EventAccess/NFCScanner/README.md

# NFCScanner
Maskinvare &amp; Firmware for in/ut-scanning

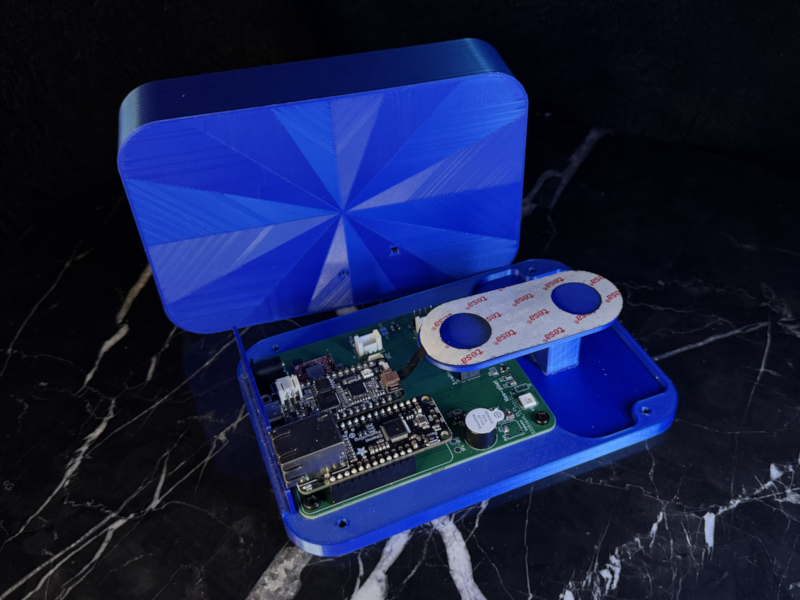
[picture p1: doc/img/prototype_0.0.4+case_800.png]
Picture of first prototype, fully assembled but with top cover off
