EventAccess/NFCScanner/hardware/Case/Cost calculations.md

backplate: 0.96m / 2.32cm³ / 2.87g
top: 26.77m / 64.39cm³ / (calculated 79.835700886g)
bottom: 19.19m / 46151.52mm³ / 57.23g
antenna shelf: 2.21m / 5325.38mm³ / 6.6g

ca. cost for 1x case: 112kr (prusament single spool 1kg, shipped - litt over halve prisen er porto)
this does not account for the back-plate, for example, needing multiple iterations.

Based on a single spool of filament at 30€, and todays currency conversion (XE), and also including the 34.5€ for cheapest shipping (direct from Prusa).
