EventAccess/NFCScanner/hardware/Case/Case.FCStd

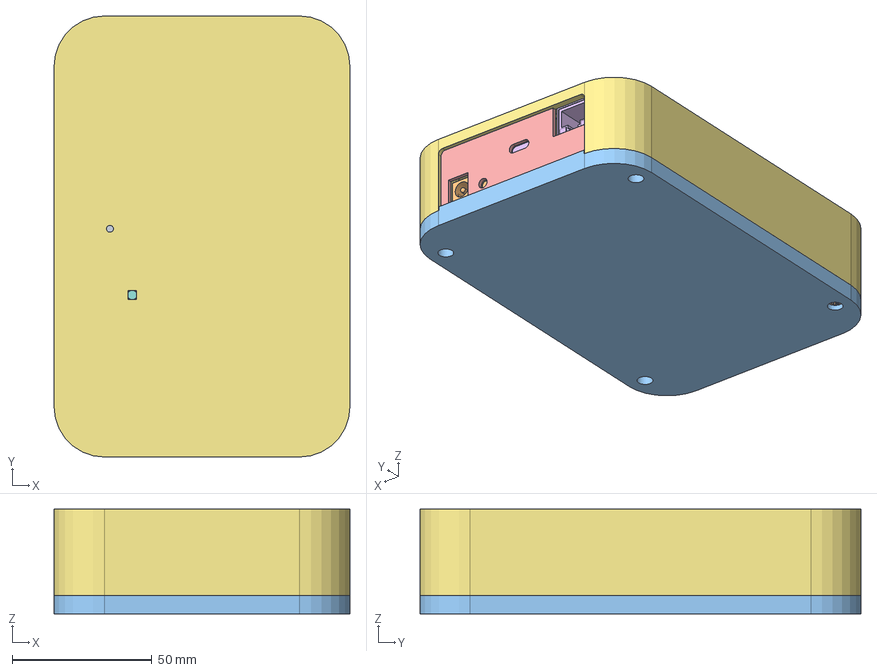
[picture p2: CAD file, 2025-02-13]
hardware/Case/Case.FCStd
106.0 x 158.0 x 37.5 mm
PinHeader_1x03_P254mm_Vertical
CUI_DEVICES_TS11-674-105-BK-260-RA-D
Grove Connector (standing)
SOT_23_5
Grove Connector (standing)001
PinHeader_1x04_P254mm_Vertical
SparkFun_Buck_Regulator_AP63357DV-7_BabyBuck5V_boardonly 1
SOT_323_SC_70
AT-1224-TWT-5V-2-R
BarrelJack_Horizontal
PinHeader_1x04_P254mm_Vertical001
SOT_323_SC_071
BM04B-SRSS-TBT
Adafruit Ethernet FeatherWing v2
PinSocket_1x16_P2.54mm_Vertical
PinSocket_1x12_P2.54mm_Vertical
PinHeader_1x16_P254mm_Vertical
PinHeader_1x12_P254mm_Vertical
PinSocket_1x16_P2.54mm_Vertical002
PinSocket_1x12_P2.54mm_Vertical002
PinHeader_1x16_P254mm_Vertical001
PinHeader_1x12_P254mm_Vertical001
PinSocket_1x03_P2.54mm_Vertical
LED_WS2812B_PLCC4_50x50mm_P32mm
NfcCarrierBoard_PCB
AntennaBody
BottomBody
M3x4-Insert x 3
BackPanelBody
USBPortBody
TopBody
AntennaShelfBody
M3x4-Insert004
M3x6-Screw004
