EventAccess/NFCScanner/hardware/NfcCarrierBoard/NfcCarrierBoard.kicad_pcb

## KiCad design hardware/NfcCarrierBoard/NfcCarrierBoard.kicad_pcb (2025-02-13)

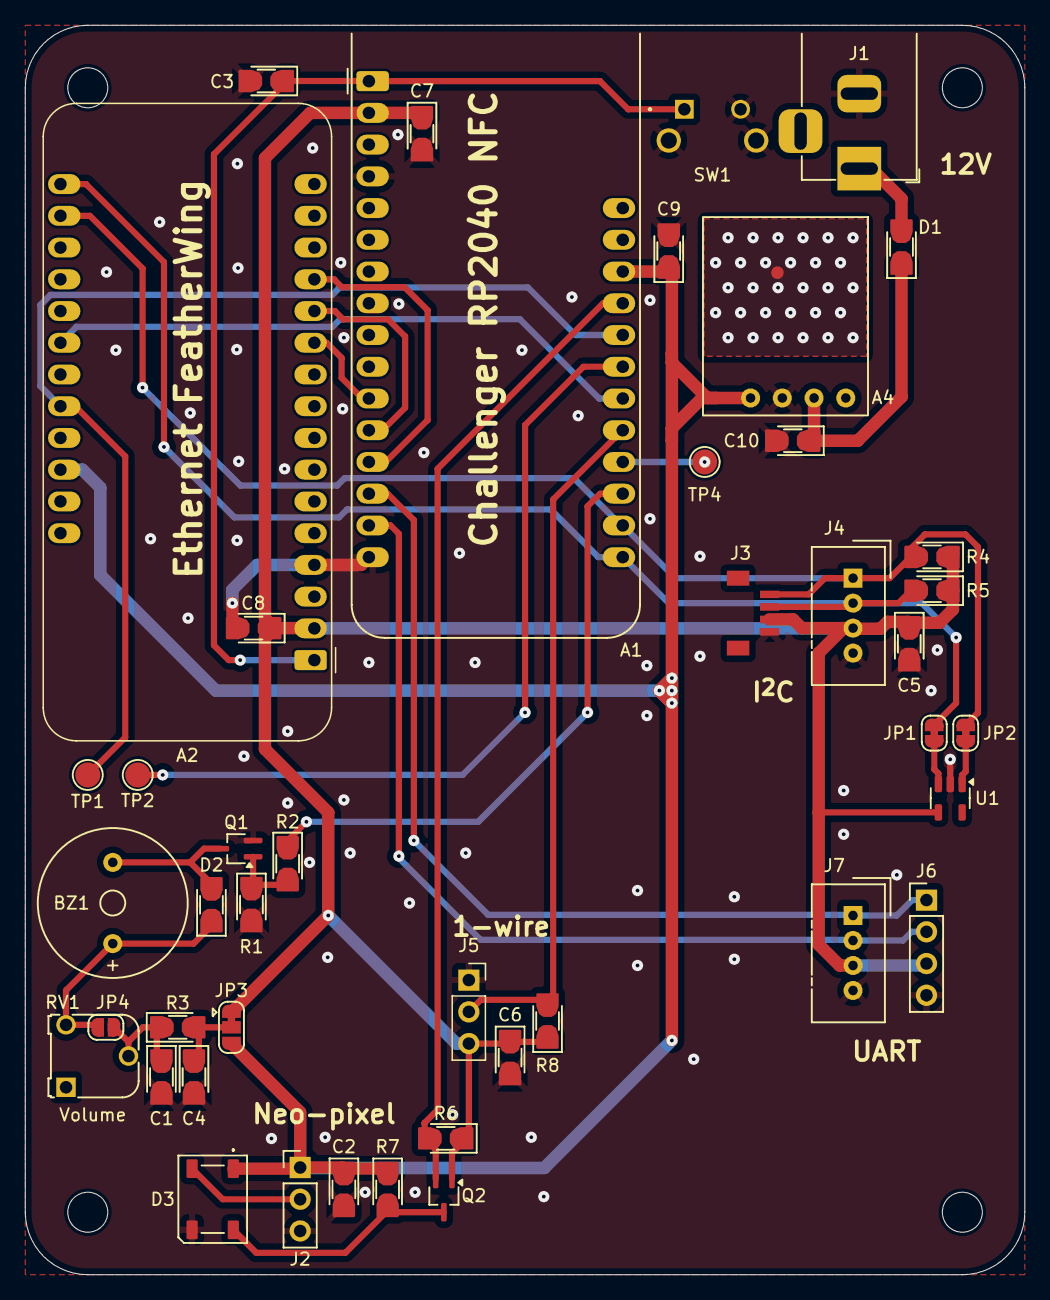
[picture p3: board NfcCarrierBoard.kicad_pcb from above]

Board: 2 copper layers, 80.0 x 100.0 mm, 50 parts (1 on the bottom side), 29 nets.

Parts:
A1: iLabs Challenger RP2040 NFC; Adafruit_Feather
A2: Ethernet FeatherWing; Adafruit_Feather
A4: 5V 3A Buck Reg; SparkFun BabyBuck Regulator 5V
BZ1: Buzzer; Buzzer_PUIaudio_AT-1224-TWT_D12_H9_6.5mm
C1: 10µF; SMD_HANDSOLDER_UNIVERSAL_0603_0805_1206
C2, C3, C4, C5, C6, C7, C8, C9, C10: 0.1µF; SMD_HANDSOLDER_UNIVERSAL_0603_0805_1206
D1, D2: SL54A; SMD_HANDSOLDER_UNIVERSAL_0603_0805_1206
D3: WS2812B; LED_WS2812B_PLCC4_5.0x5.0mm_P3.2mm
H1, H2, H3, H4: MountingHole; MountingHole_3.2mm_M3
HS1: TestPoint; TestPoint_Pad_D1.0mm
J1: Barrel_Jack; BarrelJack_Horizontal
J2: Conn_01x03; PinHeader_1x03_P2.54mm_Vertical
J3: JST SH 4; JST-SH-4-top
J4: Grove; NS-Tech_Grove_1x04_P2mm_Vertical
J5: Conn_01x03; PinSocket_1x03_P2.54mm_Vertical
J6: UART; PinHeader_1x04_P2.54mm_Vertical
J7: Grove UART; NS-Tech_Grove_1x04_P2mm_Vertical
JP1, JP2: SolderJumper_2_Bridged; SolderJumper-2_P1.3mm_Bridged_RoundedPad1.0x1.5mm
JP3: SolderJumper_3_Bridged12; SolderJumper-3_P1.3mm_Bridged12_RoundedPad1.0x1.5mm
JP4: SolderJumper_2_Open; SolderJumper-2_P1.3mm_Open_RoundedPad1.0x1.5mm
Q1, Q2: NMOS; SOT-323_SC-70_Handsoldering
R1, R4, R5, R6, R7: 10kΩ; SMD_HANDSOLDER_UNIVERSAL_0603_0805_1206
R2: 330Ω; SMD_HANDSOLDER_UNIVERSAL_0603_0805_1206
R3: ~10Ω; SMD_HANDSOLDER_UNIVERSAL_0603_0805_1206
R8: 4.7kΩ; SMD_HANDSOLDER_UNIVERSAL_0603_0805_1206
RV1: R_Potentiometer_Trim; Potentiometer_Runtron_RM-065_Vertical
SW1: RESET; SW_TS11-674-105-BK-260-RA-D
SYM1: Logo_Open_Hardware_Small; OSHW-Logo_19x20mm_SilkScreen
TP1, TP2, TP4: TestPoint; TestPoint_Pad_D2.0mm
U1: 24AA02E48T; SOT-23-5

Connections:
1-Wire DQ: A1.21 (D9), J5.2, R8.2
+3.3V: A1.2 (3V3), A2.2 (3.3V), C5.1, C6.1, C7.1, C8.1, J3.2, J4.3, J5.3, J6.3, J7.3, JP3.1 (A), Q2.1 (G), R4.1, R5.1, R6.1, R8.1, U1.4 (V_{CC})
+5V: A1.26 (USB), A2.26 (PoE_5V), A4.4 (VOUT), C2.1, C9.1, D3.1 (VDD), J2.1, JP3.3 (B), R7.1
+12V: A4.2 (VIN), C10.1, D1.1 (K)
+12V Input: D1.2 (A), J1.1
BUZZER: A1.19 (D5), R2.1
Ethernet ~CS: A1.22 (D10), A2.22 (~CS)
Ethernet ~IRQ: A1.24 (D12), A2.24 (~IRQ), TP1.1
Ethernet ~RST: A1.23 (D11), TP2.1
GND: A1.4 (GND), A1.16 (GND), A2.4 (GND), A4.3 (GND), C1.2, C2.2, C3.2, C4.2, C5.2, C6.2, C7.2, C8.2, C9.2, C10.2, D3.3 (VSS), J1.2, J2.3, J3.1, J4.4, J5.1, J6.4, J7.4, Q1.2 (S), R1.2, SW1.2, SW1.SH (B), U1.2 (V_{SS})
NEO_DI: D3.4 (DIN), Q2.3 (D), R7.2
NEO_DI_LV: A1.25 (D13), Q2.2 (S), R6.2
NEO_DO: D3.2 (DOUT), J2.2
unnamed: A1.20 (D6), TP4.1
unnamed: BZ1.1 (+), D2.1 (K), JP4.1 (A), RV1.3
unnamed: BZ1.2 (-), D2.2 (A), Q1.3 (D)
unnamed: JP1.1 (A), U1.3 (SDA)
unnamed: JP2.1 (A), U1.1 (SCL)
unnamed: C4.1, JP3.2 (C), R3.2
unnamed: C1.1, JP4.2 (B), R3.1, RV1.2
unnamed: Q1.1 (G), R1.1, R2.2
RX: A1.14 (RX), J6.1, J7.1
SCK: A1.11 (SCK), A2.11 (SCK)
SCL: A1.18 (SCL), A2.18 (EEPROM_SCL), J3.4, J4.1, JP2.2 (B), R4.2
SDA: A1.17 (SDA), A2.17 (EEPROM_SDA), J3.3, J4.2, JP1.2 (B), R5.2
SDI: A1.13 (SDI), A2.13 (SDI)
SDO: A1.12 (SDO), A2.12 (SDO)
TX: A1.15 (TX), J6.2, J7.2
~RESET: A1.1 (~RESET), A2.1 (~reset_button), C3.1, SW1.1
