EventAccess/NFCScanner/(threads)

Thread 2 (2024-09-16):

Evaluate NFC libraries

oddstr13, 2024-09-16:
- [ ] https://github.com/adamgreg/arduino-nfc
- [ ] https://github.com/ElectronicCats/ElectronicCats-PN7150

Test if it works at all, and response time/lag, the ElectronicCats library feelt slugish when I tested it last

oddstr13, 2024-09-17:
arduino-nfc does not (currently) handle the messages sent when there are multiple tags in the field.

Thread 10 (2024-10-06):

Utilize sketch.yaml with arduino-cli for dependency management

oddstr13, 2024-10-06:
Blocked by https://github.com/arduino/arduino-cli/issues/2133

Thread 15 (2024-10-19):

Long USB cable causes DHCP to fail

oddstr13, 2024-10-19:
DHCP failed consistently when I connected via a 5M USB extension cable.

Investigate why.

Too low voltage received, resulting in too little power/voltage for the Ethernet module?
Ground loop / interference?

Board: Challenger RP2040 NFC
Ethernet module: Adafruit Ethernet FeatherWing
Setup: breadboard

oddstr13, 2025-02-07:
Not seeing this issue with the v0.0.3/.4 PCB.

Presumably, the added decoupling capacitors help stabilize the voltage to the ethernet module

Closed 2025-02-07.

Thread 19 (2024-10-24):

Create carrier board (PCB)

oddstr13, 2024-10-24:
Create carrier board for the Ethernet + NFC scanner

This is what determines the layout of the IO ports on the box

It should have the following features:
 - Accept both the FeatherWing Ethernet module and the pico ethernet hat
 - Additional power input plug (For external PoE splitter)
 - Accept the Challenger RP2040 NFC board
 - Ethernet, USB and Power plug must be placed appropriate for case
 - Additional circuitry
    + Small speaker for audible notification
    + (RGB?) LED(s) for status signaling
    + Reset button for power cycling (accessible from outside case)
    + Power conditioning for stabilizing and ensuring correct voltage
    + ESD protection where appropriate

Optional:
 - Mode switch for selecting firmware mode
 - Ports for external light(strip(s)) and or speaker

Is there anything obvious I'm missing right now?

Software of choice: KiCAD

Closed 2025-02-01.

Thread 20 (2024-10-24):

Create 3D printable case

oddstr13, 2024-10-24:
Software of choice: FreeCAD (or other similarly free and open source multiplatform editor, such as OpenSCAD)

### Important measurements

- Bottom of PCB to top of ethernet port: 27.8mm
- NFC antenna extends out from the PCB by ~48mm
- NFC antenna is ~0.2mm thick, including the adhesive backing paper
- Main section of NFC antenna is ~84mm long
- The connecting wire of the NFC antenna is ~15mm long (as measured from socket to main section)
  Keep in mind that this section needs to be bent upwards slightly and carefully, in order to get the antenna at the appropriate hight
- NFC antenna width is ~34mm

Remember to include tolerances for slightly different part sizes and measurement errors.

### Design considerations

Note that the NFC antenna need to lay flat on or near the top part of the case.
It might make sense to either mount the whole board to the top of the case, or, more likely,
Create a plateau for the PCB antenna to sit on top of, with a column up from the bottom of the case, and a separate plate for placing on top that puts the antenna close to the bottom of the top case (~1mm clearance or so).
Antenna seems to have a range of ~2.5cm when reading coin style tags.

Heated inserts and machine screws as fasteners, for easy service. (These specific [inserts](https://thepihut.com/products/brass-heat-set-inserts-for-plastic-m3-x-4mm-50-pack) and [screws](https://thepihut.com/products/m3-6mm-pozi-pan-head-screws-black) have been ordered).

Separate part for back plate, to allow printing it flat for better holes (and easier re-prints if hole positions incorrect on first few attempts).

Consider bevels (and sanding), especially for top cover, to avoid sharp plastic edges (which could potentially cut skin).

Closed 2025-05-15.

Thread 42 (2025-02-06):

Incorrect pinout on ethernet SPI connection

oddstr13, 2025-02-06:
schematic component bug

breaking, needs patchwork

Closed 2025-02-06.

Thread 44 (2025-02-06):

Low volume on buzzer

oddstr13, 2025-02-06:
Even with the 5V option, it is way too quiet.

Could it be the MOSFET? or is it the 10Ω series resistor?

oddstr13, 2025-02-07:
The 2nd board with a NPN transistor (MMBT5551) seems significantly louder – this board also has the pot bypass jumper installed, but I don't think it is related to that (as I tried shorting the pot with a screwdriver with no noticable difference).

I can do a side-by-side test when I receive more microcontrollers (Transistor vs. MOSFET).

oddstr13, 2025-02-13:
After swapping out the MOSFET for a transistor, and swapping out the buzzer, I found that D2 was shorted.
Reflowing the diode solved the issue.

TODO: Test again with MOSFET

Closed 2025-02-13.

Thread 49 (2025-02-07):

Consider moving extension headers to board edge

oddstr13, 2025-02-07:
This to allow the possibility of using right angle headers (especially for the NeoPixel and 1-wire headers.

Ideally the on-board NeoPixel's location wouldn't change, as to allow reuse of "existing" case and light-pipe design (but this is not critical, as currently only the first prototype version exists, and exact placement of the NeoPixel wasn't chosen with particular care in the first place).

The front (bottom) edge (closest to NeoPixel) is the best edge for extension headers (that won't be directly exposed on the case outside), as the NFC antenna expands off the PCB edge here, demanding extra space from the case, giving some free room below.
