EventAccess/NFCScanner/(commit log)

2024-10-06 Change to custom fork of arduino-nfc
2024-10-14 Update dependency arduino/arduino-lint to v1.2.1
2024-11-07 Update dependency arduino/arduino-cli to v1.1.0
2024-11-19 Initial work on renovate updates for arduino dependencies
2024-11-19 Renovate: Add support for arduino boards manager
2024-11-19 Add tool to install arduino dependencies from manifest
2024-11-19 Update dependency ArduinoJson to v7.2.1
2024-11-22 Update dependency arduino/arduino-cli to v1.1.1
2024-11-22 Initial work on carrier board
    [NfcCarrierBoard.kicad_pcb, NfcCarrierBoard.kicad_sch]
2024-12-19 Update dependency arduino/arduino-lint to v1.3.0
2024-12-29 Update dependency ArduinoJson to v7.3.0
2025-01-07 Configure DRC to hopefully match DirtyPCBs and JLC PCB
2025-01-07 Add BabyBuck regulator symbol
2025-01-07 Lots of schematic changes that should have been commited incrementally.
    [NfcCarrierBoard.kicad_sch]
2025-01-07 Change 12V input symbol to jack with switch
    [NfcCarrierBoard.kicad_sch]
2025-01-07 Add 1-Wire header
    [NfcCarrierBoard.kicad_sch]
2025-01-09 Add decopuling caps
    [NfcCarrierBoard.kicad_sch]
2025-01-10 Add PoE FeatherWing pinouts Add UART headers Fix some ERC errors
    [NfcCarrierBoard.kicad_sch]
2025-01-11 Add SH-4-T (Quiic/STEMMA QT) connector 3D model Downloaded from https://www.digikey.no/en/models/1991988
    BM04B-SRSS-TBT
    JST Sales America Inc.
    CONN HEADER SMD 4POS 1MM
2025-01-11 Add SH-4-T connector footprint
2025-01-11 Add Buzzer footprint
2025-01-11 Change MOSFET symbols to match pinout of selected parts Add and select more footprints
    [NfcCarrierBoard.kicad_sch]
2025-01-11 Add testpoint pads to unused pins
    [NfcCarrierBoard.kicad_sch]
2025-01-11 Add jumper to select between 3.3V and 5V for audio
    [NfcCarrierBoard.kicad_sch]
2025-01-13 Add jumper to bypass audio pot
    [NfcCarrierBoard.kicad_sch]
2025-01-13 Add custom footprint for the Ethernet FeatherWing
2025-01-13 Add mounting holes Add OSHW logo Change Ethernet footprint
    [NfcCarrierBoard.kicad_sch]
2025-01-14 Add custom footprint for 0603 0805 1206 jellybean parts
    [NfcCarrierBoard.kicad_sch]
2025-01-14 Add reset switch footprint and 3d model
    [NfcCarrierBoard.kicad_sch]
2025-01-14 Update switch footprint to match KiCAD pin naming
    [NfcCarrierBoard.kicad_sch]
2025-01-14 Link switch footprint to 3D model
2025-01-14 Begin work on PCB layout
    [NfcCarrierBoard.kicad_pcb, NfcCarrierBoard.kicad_sch]
2025-01-19 Populate more of the PCB Some DRC fixes
    [NfcCarrierBoard.kicad_pcb, NfcCarrierBoard.kicad_sch]
2025-01-19 Place last components
    [NfcCarrierBoard.kicad_pcb, NfcCarrierBoard.kicad_sch]
2025-01-19 Reduce some sharp angles on signal traces
    [NfcCarrierBoard.kicad_pcb]
2025-01-20 Add heatsink pad Add silkscreen
    [NfcCarrierBoard.kicad_pcb, NfcCarrierBoard.kicad_sch]
2025-01-21 Adjust silkscreen Expose heatsink pad
    [NfcCarrierBoard.kicad_pcb]
2025-01-21 Add script to render gerbers (and more)
2025-01-21 Fix rule errors
    [NfcCarrierBoard.kicad_sch]
2025-01-21 Fix off-board silkscreen
    [NfcCarrierBoard.kicad_pcb, NfcCarrierBoard.kicad_sch]
2025-01-21 Render schematic pdf Export BOM
2025-01-21 Make rendered output appropriate for OSHPark and PCBWay
2025-01-22 Populate part numbers for BOM
    [NfcCarrierBoard.kicad_pcb, NfcCarrierBoard.kicad_sch]
2025-01-26 Populate resistors for BOM
    [NfcCarrierBoard.kicad_sch]
2025-01-28 Populate capacitors for BOM
    [NfcCarrierBoard.kicad_sch]
2025-01-30 Fix BOM output
    [NfcCarrierBoard.kicad_sch]
2025-02-05 Import updated BOM from schematic to PCB
    [NfcCarrierBoard.kicad_pcb]
2025-02-05 Add interactive BOM config
2025-02-06 Fix #42
    [NfcCarrierBoard.kicad_pcb, NfcCarrierBoard.kicad_sch]
2025-02-07 Read MAC address from EEPROM
    Fixes #11
    [src.ino]
2025-02-07 Add Grove connector 3D model
    [NfcCarrierBoard.kicad_pcb]
2025-02-08 Create STEP 3D model of board
2025-02-08 Add Adafruit Ethernet FeatherWing 3D model
    [NfcCarrierBoard.kicad_pcb]
2025-02-08 Add buzzer 3D model
    [NfcCarrierBoard.kicad_pcb]
2025-02-08 Render 3D images of board using KiCAD nightly
    [NfcCarrierBoard.kicad_pcb]
2025-02-08 Change footprint for 1-wire header Not an electrical/physical board change, but this makes 3D renders show the proper connector
    [NfcCarrierBoard.kicad_pcb, NfcCarrierBoard.kicad_sch]
2025-02-08 Add header models to feather footprints
    [NfcCarrierBoard.kicad_pcb]
2025-02-09 Add BabyBuck board outline
    [NfcCarrierBoard.kicad_pcb]
2025-02-09 Start work on case design
    [Case.FCStd]
2025-02-10 Case Base r1
    [Case.FCStd]
2025-02-11 Case add top
    [Case.FCStd]
2025-02-12 Case v1?
    [Case.FCStd]
2025-02-12 Case Printed
    [Case.FCStd]
2025-02-13 Add neopixel and buzzer output
    [src.ino]
2025-02-13 Add print cost estimate
2025-02-24 Update dependency arduino/arduino-cli to v1.2.0
2025-02-27 Update dependency ArduinoJson to v7.3.1
2025-04-11 Update dependency ArduinoJson to v7.4.1
2025-04-22 Update dependency arduino/arduino-cli to v1.2.2
2025-06-20 Update dependency ArduinoJson to v7.4.2
2025-11-22 Add picture of finished prototype to readme
    Photo by @wiwivault (Instagram)
